gorbit99/penguin/kicad/LPKeyboard.kicad_sch

## KiCad design kicad/LPKeyboard.kicad_sch (2022-07-28)

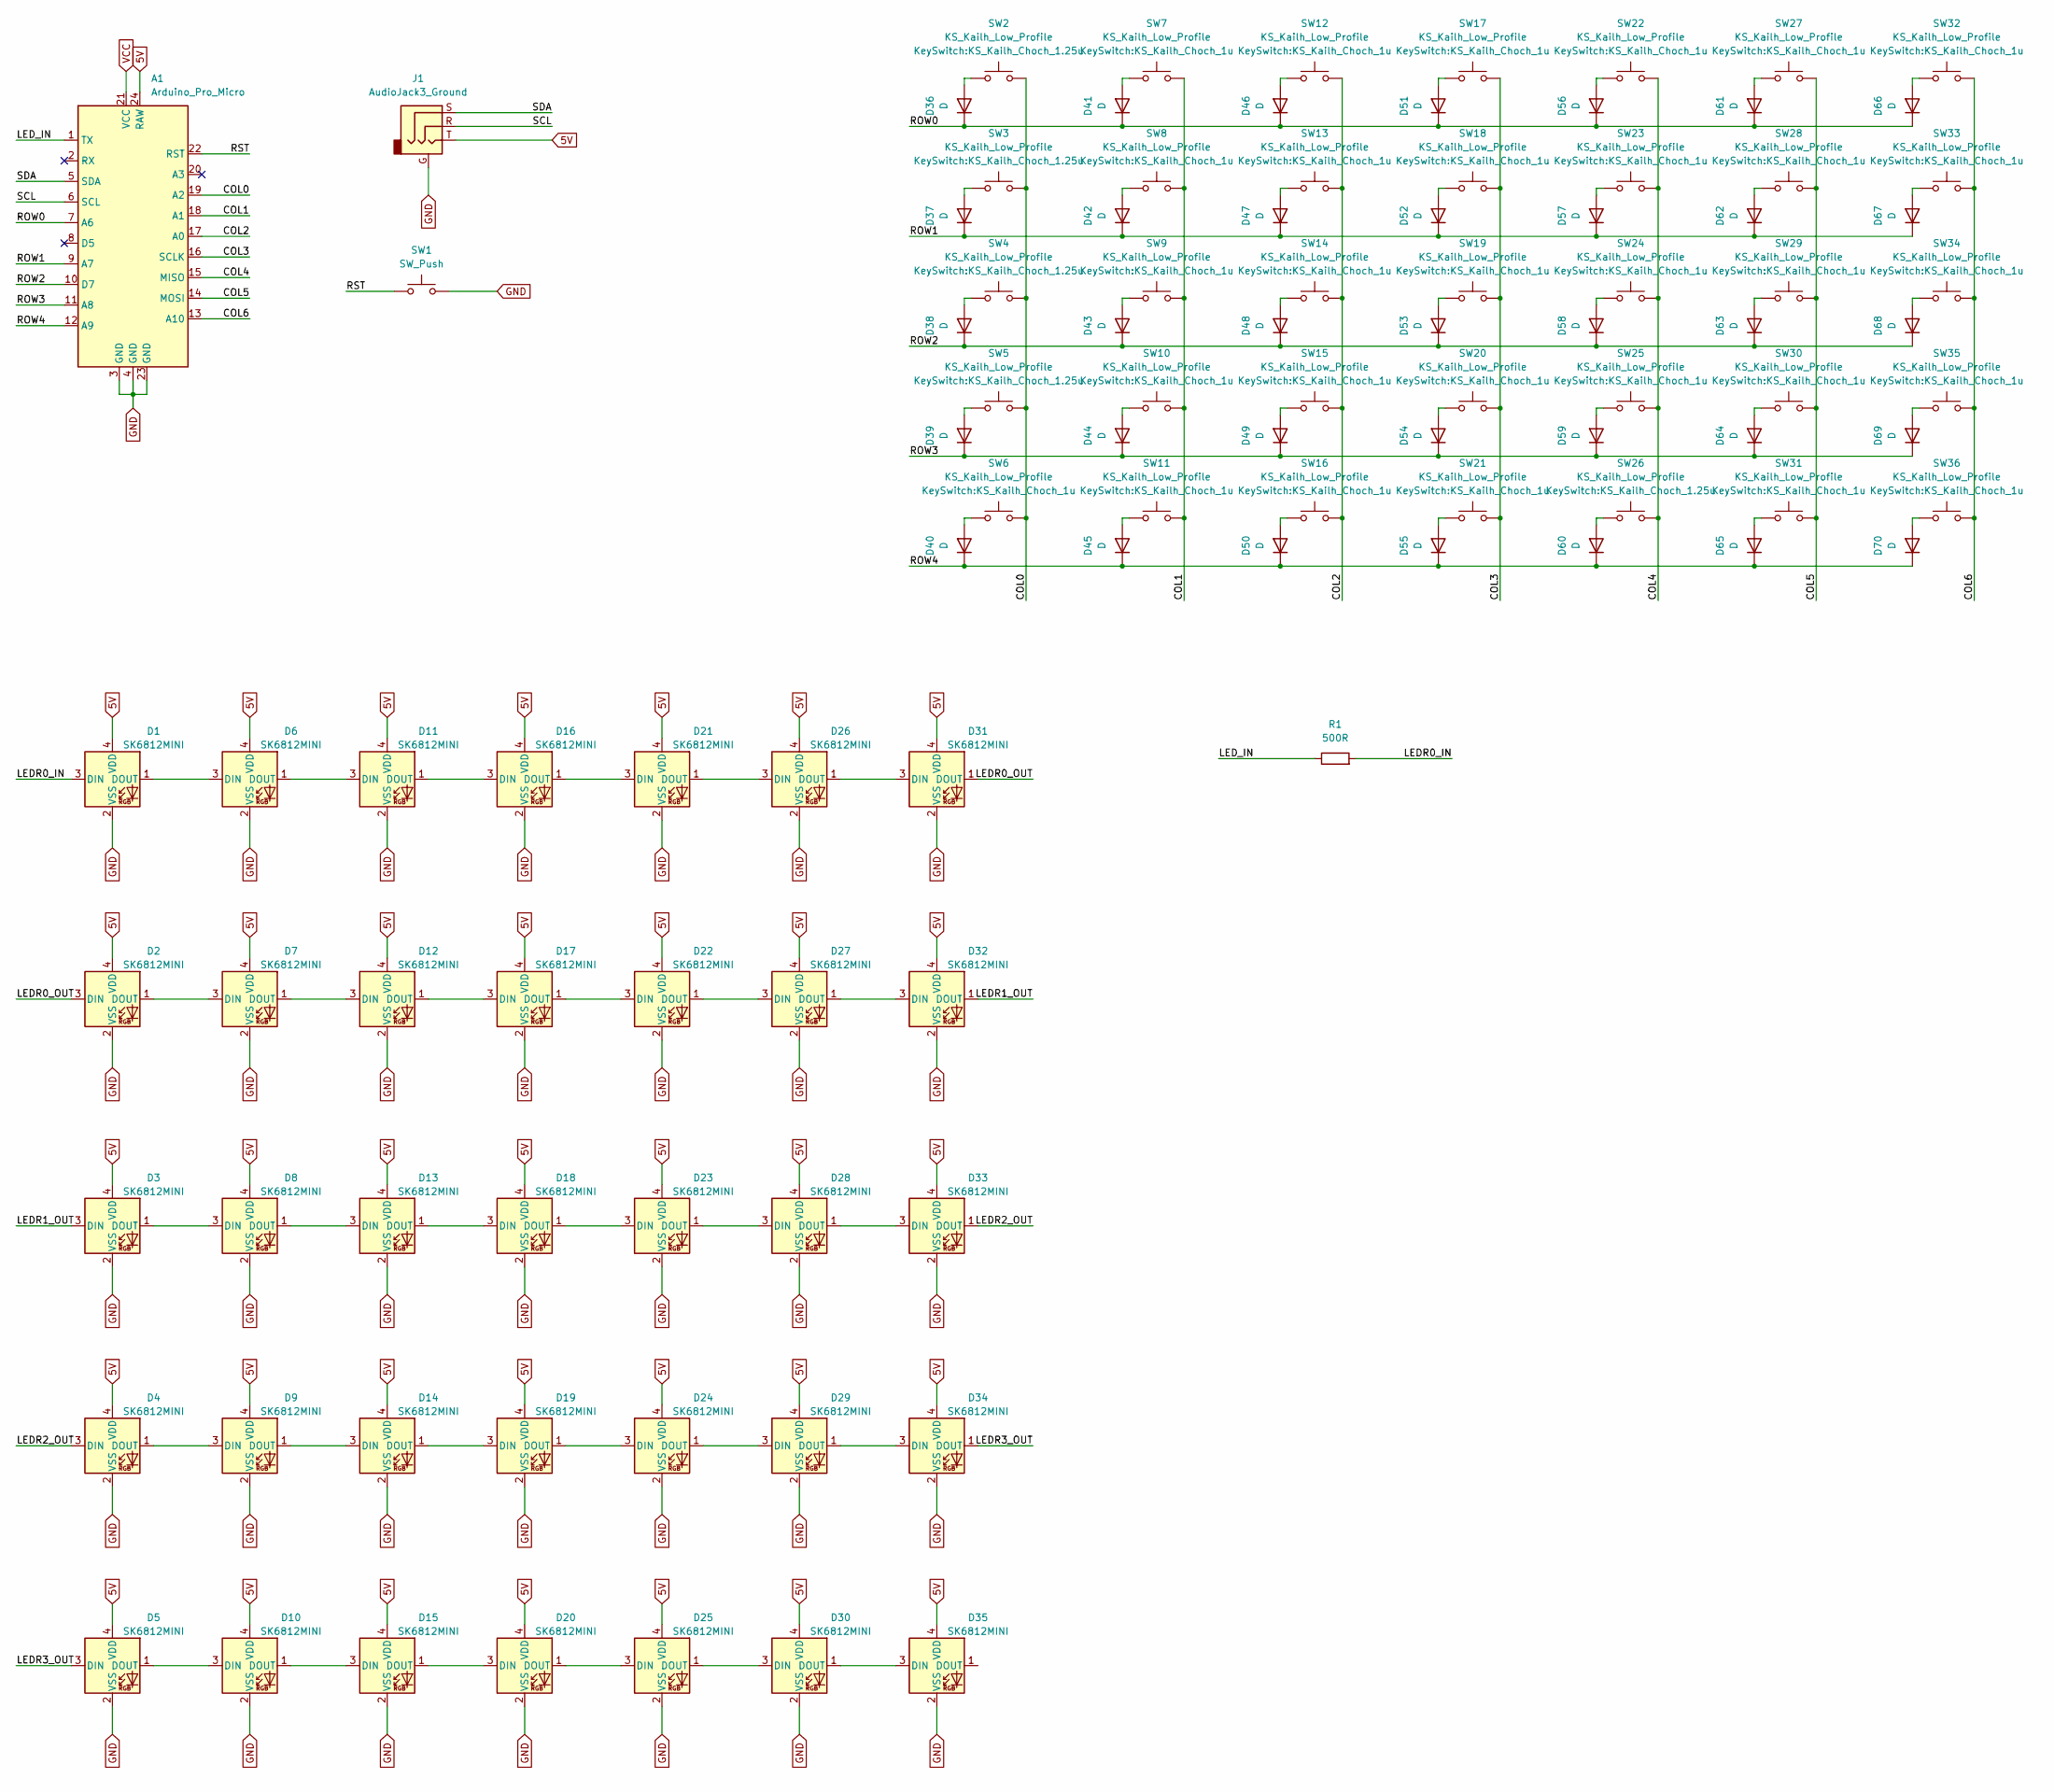
[picture p1: schematic LPKeyboard.kicad_sch]

Parts:
A1: Arduino_Pro_Micro; Arduino_Pro_Micro_USB_C
D1, D2, D3, D4, D5, D6, D7, D8, D9, D10, D11, D12, D13, D14, D15, D16, D17, D18, D19, D20, D21, D22, D23, D24, D25, D26, D27, D28, D29, D30, D31, D32, D33, D34, D35: SK6812MINI; SK6812-MINI-E
D36, D37, D38, D39, D40, D41, D42, D43, D44, D45, D46, D47, D48, D49, D50, D51, D52, D53, D54, D55, D56, D57, D58, D59, D60, D61, D62, D63, D64, D65, D66, D67, D68, D69, D70: D; D_SOD-123
J1: AudioJack3_Ground; TRRS-PJ-320A
R1: 500R; R_0603_1608Metric
SW1: SW_Push; SW_PUSH_6mm_H4.3mm
SW2, SW3, SW4, SW5, SW26: KS_Kailh_Low_Profile; KS_Kailh_Choch_1.25u
SW6, SW7, SW8, SW9, SW10, SW11, SW12, SW13, SW14, SW15, SW16, SW17, SW18, SW19, SW20, SW21, SW22, SW23, SW24, SW25, SW27, SW28, SW29, SW30, SW31, SW32, SW33, SW34, SW35, SW36: KS_Kailh_Low_Profile; KS_Kailh_Choch_1u

Connections:
5V: A1.24 (RAW), D1.4 (VDD), D2.4 (VDD), D3.4 (VDD), D4.4 (VDD), D5.4 (VDD), D6.4 (VDD), D7.4 (VDD), D8.4 (VDD), D9.4 (VDD), D10.4 (VDD), D11.4 (VDD), D12.4 (VDD), D13.4 (VDD), D14.4 (VDD), D15.4 (VDD), D16.4 (VDD), D17.4 (VDD), D18.4 (VDD), D19.4 (VDD), D20.4 (VDD), D21.4 (VDD), D22.4 (VDD), D23.4 (VDD), D24.4 (VDD), D25.4 (VDD), D26.4 (VDD), D27.4 (VDD), D28.4 (VDD), D29.4 (VDD), D30.4 (VDD), D31.4 (VDD), D32.4 (VDD), D33.4 (VDD), D34.4 (VDD), D35.4 (VDD), J1.T
COL0: A1.19 (A2), SW2.2, SW3.2, SW4.2, SW5.2, SW6.2
COL1: A1.18 (A1), SW7.2, SW8.2, SW9.2, SW10.2, SW11.2
COL2: A1.17 (A0), SW12.2, SW13.2, SW14.2, SW15.2, SW16.2
COL3: A1.16 (SCLK), SW17.2, SW18.2, SW19.2, SW20.2, SW21.2
COL4: A1.15 (MISO), SW22.2, SW23.2, SW24.2, SW25.2, SW26.2
COL5: A1.14 (MOSI), SW27.2, SW28.2, SW29.2, SW30.2, SW31.2
COL6: A1.13 (A10), SW32.2, SW33.2, SW34.2, SW35.2, SW36.2
GND: A1.3 (GND), A1.4 (GND), A1.23 (GND), D1.2 (VSS), D2.2 (VSS), D3.2 (VSS), D4.2 (VSS), D5.2 (VSS), D6.2 (VSS), D7.2 (VSS), D8.2 (VSS), D9.2 (VSS), D10.2 (VSS), D11.2 (VSS), D12.2 (VSS), D13.2 (VSS), D14.2 (VSS), D15.2 (VSS), D16.2 (VSS), D17.2 (VSS), D18.2 (VSS), D19.2 (VSS), D20.2 (VSS), D21.2 (VSS), D22.2 (VSS), D23.2 (VSS), D24.2 (VSS), D25.2 (VSS), D26.2 (VSS), D27.2 (VSS), D28.2 (VSS), D29.2 (VSS), D30.2 (VSS), D31.2 (VSS), D32.2 (VSS), D33.2 (VSS), D34.2 (VSS), D35.2 (VSS), J1.G, SW1.2
LEDR0_IN: D1.3 (DIN), R1.2
LEDR0_OUT: D2.3 (DIN), D31.1 (DOUT)
LEDR1_OUT: D3.3 (DIN), D32.1 (DOUT)
LEDR2_OUT: D4.3 (DIN), D33.1 (DOUT)
LEDR3_OUT: D5.3 (DIN), D34.1 (DOUT)
LED_IN: A1.1 (TX), R1.1
unnamed: D1.1 (DOUT), D6.3 (DIN)
unnamed: D2.1 (DOUT), D7.3 (DIN)
unnamed: D3.1 (DOUT), D8.3 (DIN)
unnamed: D4.1 (DOUT), D9.3 (DIN)
unnamed: D10.1 (DOUT), D15.3 (DIN)
unnamed: D5.1 (DOUT), D10.3 (DIN)
unnamed: D11.1 (DOUT), D16.3 (DIN)
unnamed: D6.1 (DOUT), D11.3 (DIN)
unnamed: D12.1 (DOUT), D17.3 (DIN)
unnamed: D7.1 (DOUT), D12.3 (DIN)
unnamed: D13.1 (DOUT), D18.3 (DIN)
unnamed: D8.1 (DOUT), D13.3 (DIN)
unnamed: D14.1 (DOUT), D19.3 (DIN)
unnamed: D9.1 (DOUT), D14.3 (DIN)
unnamed: D15.1 (DOUT), D20.3 (DIN)
unnamed: D16.1 (DOUT), D21.3 (DIN)
unnamed: D17.1 (DOUT), D22.3 (DIN)
unnamed: D18.1 (DOUT), D23.3 (DIN)
unnamed: D19.1 (DOUT), D24.3 (DIN)
unnamed: D20.1 (DOUT), D25.3 (DIN)
unnamed: D21.1 (DOUT), D26.3 (DIN)
unnamed: D22.1 (DOUT), D27.3 (DIN)
unnamed: D23.1 (DOUT), D28.3 (DIN)
unnamed: D24.1 (DOUT), D29.3 (DIN)
unnamed: D25.1 (DOUT), D30.3 (DIN)
unnamed: D26.1 (DOUT), D31.3 (DIN)
unnamed: D27.1 (DOUT), D32.3 (DIN)
unnamed: D28.1 (DOUT), D33.3 (DIN)
unnamed: D29.1 (DOUT), D34.3 (DIN)
unnamed: D30.1 (DOUT), D35.3 (DIN)
unnamed: D36.2 (A), SW2.1
unnamed: D37.2 (A), SW3.1
unnamed: D38.2 (A), SW4.1
unnamed: D39.2 (A), SW5.1
unnamed: D40.2 (A), SW6.1
unnamed: D41.2 (A), SW7.1
unnamed: D42.2 (A), SW8.1
unnamed: D43.2 (A), SW9.1
unnamed: D44.2 (A), SW10.1
unnamed: D45.2 (A), SW11.1
unnamed: D46.2 (A), SW12.1
unnamed: D47.2 (A), SW13.1
unnamed: D48.2 (A), SW14.1
unnamed: D49.2 (A), SW15.1
unnamed: D50.2 (A), SW16.1
unnamed: D51.2 (A), SW17.1
unnamed: D52.2 (A), SW18.1
unnamed: D53.2 (A), SW19.1
unnamed: D54.2 (A), SW20.1
unnamed: D55.2 (A), SW21.1
unnamed: D56.2 (A), SW22.1
unnamed: D57.2 (A), SW23.1
unnamed: D58.2 (A), SW24.1
unnamed: D59.2 (A), SW25.1
unnamed: D60.2 (A), SW26.1
unnamed: D61.2 (A), SW27.1
unnamed: D62.2 (A), SW28.1
unnamed: D63.2 (A), SW29.1
unnamed: D64.2 (A), SW30.1
unnamed: D65.2 (A), SW31.1
unnamed: D66.2 (A), SW32.1
unnamed: D67.2 (A), SW33.1
unnamed: D68.2 (A), SW34.1
unnamed: D69.2 (A), SW35.1
unnamed: D70.2 (A), SW36.1
ROW0: A1.7 (A6), D36.1 (K), D41.1 (K), D46.1 (K), D51.1 (K), D56.1 (K), D61.1 (K), D66.1 (K)
ROW1: A1.9 (A7), D37.1 (K), D42.1 (K), D47.1 (K), D52.1 (K), D57.1 (K), D62.1 (K), D67.1 (K)
ROW2: A1.10 (D7), D38.1 (K), D43.1 (K), D48.1 (K), D53.1 (K), D58.1 (K), D63.1 (K), D68.1 (K)
ROW3: A1.11 (A8), D39.1 (K), D44.1 (K), D49.1 (K), D54.1 (K), D59.1 (K), D64.1 (K), D69.1 (K)
ROW4: A1.12 (A9), D40.1 (K), D45.1 (K), D50.1 (K), D55.1 (K), D60.1 (K), D65.1 (K), D70.1 (K)
RST: A1.22 (RST), SW1.1
SCL: A1.6 (SCL), J1.R
SDA: A1.5 (SDA), J1.S
VCC: A1.21 (VCC)
