gorbit99/penguin/qmk/rev1/config.h

/*
Copyright 2018 Mattia Dal Ben <matthewdibi@gmail.com>

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
You should have received a copy of the GNU General Public License
along with this program.  If not, see <http://www.gnu.org/licenses/>.
*/

#pragma once

#include "config_common.h"

/* USB Device descriptor parameter */
#define VENDOR_ID 0xFEED
#define PRODUCT_ID 0x9627
#define DEVICE_VER 0x0100

/* key matrix size */
// Rows are doubled-up
#define MATRIX_ROWS 10
#define MATRIX_COLS 7

// wiring of each half
#define MATRIX_ROW_PINS                                                        \
  { D4, D7, E6, B4, B5 }
#define MATRIX_COL_PINS                                                        \
  { F5, F6, F7, B1, B3, B2, B6 }
// #define MATRIX_COL_PINS { B6, B2, B3, B1, F7, F6, F5} //uncomment this line
// and comment line above if you need to reverse left-to-right key order

/* COL2ROW or ROW2COL */
#define DIODE_DIRECTION COL2ROW

/* define if matrix has ghost */
//#define MATRIX_HAS_GHOST

/* number of backlight levels */
// #define BACKLIGHT_LEVELS 3

/* Set 0 if debouncing isn't needed */
#define DEBOUNCE 5

/* serial.c configuration for split keyboard */
#define SOFT_SERIAL_PIN D0

/* Mechanical locking support. Use KC_LCAP, KC_LNUM or KC_LSCR instead in keymap
 */
#define LOCKING_SUPPORT_ENABLE
/* Locking resynchronize hack */
#define LOCKING_RESYNC_ENABLE

/* ws2812 RGB LED */
#define RGB_DI_PIN D3

#define DRIVER_LED_TOTAL 70 // Number of LEDs
#define RGB_MATRIX_SPLIT                                                       \
  { 35, 35 }
#define RGB_MATRIX_MAXIMUM_BRIGHTNESS 100

#define SPLIT_TRANSPORT_MIRROR
#define RGB_MATRIX_FRAMEBUFFER_EFFECTS
#define RGB_MATRIX_KEYPRESSES
#define RGB_DISABLE_WHEN_USB_SUSPENDED true
#define RGB_DISABLE_TIMEOUT 10000

#define EE_HANDS

#define ENABLE_RGB_MATRIX_ALPHAS_MODS
#define ENABLE_RGB_MATRIX_GRADIENT_UP_DOWN
#define ENABLE_RGB_MATRIX_GRADIENT_LEFT_RIGHT
#define ENABLE_RGB_MATRIX_BREATHING
#define ENABLE_RGB_MATRIX_BAND_SAT
#define ENABLE_RGB_MATRIX_BAND_VAL
#define ENABLE_RGB_MATRIX_BAND_PINWHEEL_SAT
#define ENABLE_RGB_MATRIX_BAND_PINWHEEL_VAL
#define ENABLE_RGB_MATRIX_BAND_SPIRAL_SAT
#define ENABLE_RGB_MATRIX_BAND_SPIRAL_VAL
#define ENABLE_RGB_MATRIX_CYCLE_ALL
#define ENABLE_RGB_MATRIX_CYCLE_LEFT_RIGHT
#define ENABLE_RGB_MATRIX_CYCLE_UP_DOWN
#define ENABLE_RGB_MATRIX_RAINBOW_MOVING_CHEVRON
#define ENABLE_RGB_MATRIX_CYCLE_OUT_IN
#define ENABLE_RGB_MATRIX_CYCLE_OUT_IN_DUAL
#define ENABLE_RGB_MATRIX_CYCLE_PINWHEEL
#define ENABLE_RGB_MATRIX_CYCLE_SPIRAL
#define ENABLE_RGB_MATRIX_DUAL_BEACON
#define ENABLE_RGB_MATRIX_RAINBOW_BEACON
#define ENABLE_RGB_MATRIX_RAINBOW_PINWHEELS
#define ENABLE_RGB_MATRIX_RAINDROPS
#define ENABLE_RGB_MATRIX_JELLYBEAN_RAINDROPS
#define ENABLE_RGB_MATRIX_HUE_BREATHING
#define ENABLE_RGB_MATRIX_HUE_PENDULUM
#define ENABLE_RGB_MATRIX_HUE_WAVE
#define ENABLE_RGB_MATRIX_PIXEL_RAIN
#define ENABLE_RGB_MATRIX_PIXEL_FLOW
#define ENABLE_RGB_MATRIX_PIXEL_FRACTAL
#define ENABLE_RGB_MATRIX_TYPING_HEATMAP
#define ENABLE_RGB_MATRIX_DIGITAL_RAIN
#define ENABLE_RGB_MATRIX_SOLID_REACTIVE_SIMPLE
#define ENABLE_RGB_MATRIX_SOLID_REACTIVE
#define ENABLE_RGB_MATRIX_SOLID_REACTIVE_WIDE
#define ENABLE_RGB_MATRIX_SOLID_REACTIVE_MULTIWIDE
#define ENABLE_RGB_MATRIX_SOLID_REACTIVE_CROSS
#define ENABLE_RGB_MATRIX_SOLID_REACTIVE_MULTICROSS
#define ENABLE_RGB_MATRIX_SOLID_REACTIVE_NEXUS
#define ENABLE_RGB_MATRIX_SOLID_REACTIVE_MULTINEXUS
#define ENABLE_RGB_MATRIX_SPLASH
#define ENABLE_RGB_MATRIX_MULTISPLASH
#define ENABLE_RGB_MATRIX_SOLID_SPLASH
#define ENABLE_RGB_MATRIX_SOLID_MULTISPLASH
